SANCHAIE/rover-90-workshop/handouts/ใบตรวจสาย.docx

ใบตรวจสาย ROVER 90

ทีมที่ / ชื่อทีม | สมาชิก | เวลาที่เริ่ม

ต่อให้ครบทุกเส้น ทำเครื่องหมายในช่องขวาสุด แล้วยกมือเรียกครูตรวจ ห้ามเปิดสวิตช์ถ่านก่อนครูเซ็นชื่อ

กลุ่มที่ 1 ไฟเลี้ยง — ต่อกลุ่มนี้ให้เสร็จและถูกก่อนเสมอ

จาก | ไปที่ | เส้น | ตรวจแล้ว
กล่องถ่าน 18650 (สายแดง) | L298N ขั้ว 12V | 1
กล่องถ่าน 18650 (สายดำ) | L298N ขั้ว GND | 1
L298N ขา 5V | ESP32 ขา VIN | 1
L298N ขา GND | ESP32 ขา GND | 1

เช็ก jumper 5V-EN บน L298N ต้องคาไว้ ไม่งั้นจะไม่มีไฟ 5V ออกมาเลี้ยง ESP32

กลุ่มที่ 2 มอเตอร์และสายควบคุม

จาก | ไปที่ | เส้น | ตรวจแล้ว
มอเตอร์ซ้าย 2 เส้น | L298N OUT1 และ OUT2 | 2
มอเตอร์ขวา 2 เส้น | L298N OUT3 และ OUT4 | 2
L298N ENA | ESP32 ขา 14 | 1
L298N IN1 | ESP32 ขา 27 | 1
L298N IN2 | ESP32 ขา 26 | 1
L298N IN3 | ESP32 ขา 25 | 1
L298N IN4 | ESP32 ขา 33 | 1
L298N ENB | ESP32 ขา 32 | 1

ถอด jumper ครอบ ENA และ ENB ออกก่อน ไม่งั้นปรับความเร็วไม่ได้

กลุ่มที่ 3 เซนเซอร์ จอ และเสียง

จาก | ไปที่ | เส้น | ตรวจแล้ว
HC-SR04 VCC | ESP32 ขา 5V | 1
HC-SR04 TRIG | ESP32 ขา 5 | 1
HC-SR04 ECHO | ESP32 ขา 18 ผ่านตัวแบ่งแรงดัน | 1
OLED VCC | ESP32 ขา 3V3 (ห้ามใช้ 5V) | 1
OLED SDA | ESP32 ขา 21 | 1
OLED SCL | ESP32 ขา 22 | 1
Buzzer ขั้วบวก | ESP32 ขา 4 | 1
GND ของ HC-SR04 + OLED + Buzzer | ESP32 ขา GND (รวมกันได้) | 3

ตรวจซ้ำ 4 ข้อนี้ก่อนเรียกครู

1. ขั้วถ่านเข้า L298N ถูกด้าน ผิด = โมดูลพังทันที ควันขึ้น

2. สาย GND ระหว่าง L298N กับ ESP32 ต่ออยู่ ขาด = มอเตอร์ทำงานมั่ว หาสาเหตุยากที่สุด

3. ขา ECHO ผ่านตัวแบ่งแรงดันแล้ว ข้าม = ขา ESP32 เสื่อมแบบค่อยเป็นค่อยไป

4. OLED ใช้ไฟ 3V3 ไม่ใช่ 5V ผิด = จอไหม้

ผลการตรวจ | ลงชื่อครูผู้ตรวจ | เวลา
ผ่าน / ให้แก้ไขแล้วตรวจใหม่

เมื่อมีลายเซ็นในช่องนี้แล้วเท่านั้น จึงเปิดสวิตช์ถ่านได้
