SANCHAIE/rover-90-workshop/optional/google-sheet-iot/README.md

# ทางเลือก · ส่งข้อมูลขึ้นกราฟ Google Sheet

> **ไม่ได้ใช้ในแผนกิจกรรมปัจจุบัน** ถ้ากำลังเตรียมสอนตามแผนใน `docs/index.html`
> ให้ข้ามโฟลเดอร์นี้ไปทั้งหมด ส่วน IoT ใช้ `firmware/05_WebServer` แทน

---

## ทำไมถึงไม่ได้ใช้

แผนแรกออกแบบให้รถทุกคันยิงผลการจูนขึ้น Google Sheet ผ่านฮอตสปอตมือถือครู แล้วฉายกราฟรวมของทั้ง 15 ทีมขึ้นจอพร้อมกัน

สุดท้ายเปลี่ยนไปใช้ SoftAP บนตัวรถแทน ด้วยสามเหตุผล

- ฮอตสปอตมือถือรับได้แค่ 5 เครื่อง (iPhone) ถึง 10 เครื่อง (Android) ไม่พอสำหรับ 15 ทีม ต้องหมุนเวียนเข้าคิว
- ต้องเตรียม Apps Script และ Deploy ล่วงหน้า ถ้าตั้งค่าพลาดจุดเดียวคือใช้ไม่ได้ทั้งห้อง
- ถ้าเน็ตล่มกลางคาบ ส่วน IoT หายไปทั้งช่วง ไม่มีทางถอย

`05_WebServer` ไม่ต้องมีเราเตอร์ ไม่ต้องมีเน็ต ไม่ต้องตั้งค่าอะไรล่วงหน้าเลย

## เมื่อไรถึงควรกลับมาใช้

โค้ดในโฟลเดอร์นี้ทดสอบแล้วและใช้ได้จริง เก็บไว้เผื่อกรณี

- ห้องมี WiFi ที่ควบคุมได้เอง และอยากได้กราฟเปรียบเทียบทั้งห้องฉายขึ้นจอ
- จำนวนทีมน้อยกว่า 8 ทีม ฮอตสปอตมือถือรับไหว
- อยากสอนเรื่องการส่งข้อมูลขึ้นคลาวด์จริง ๆ ไม่ใช่แค่เว็บเซิร์ฟเวอร์ในเครื่อง

## ไฟล์ในโฟลเดอร์นี้

| ไฟล์ | คืออะไร |
|---|---|
| `setup.md` | คู่มือติดตั้ง Google Sheet และ Apps Script 7 ขั้น |
| `Code.gs` | สคริปต์ฝั่ง Google Sheet รับข้อมูลแล้วเขียนลงแท็บ `data` |
| `05_SendToSheet/` | สเก็ตช์ ESP32 เชื่อม WiFi ยิงข้อมูล แล้วตัดการเชื่อมต่อใน 5 วินาที |
