SANCHAIE/rover-90-workshop/handouts/ใบงานนักเรียน.docx

ใบงาน ROVER 90

ต่อวงจรเอง เขียนโค้ดเอง ปรับจูนจนแม่น

ทีมที่ / ชื่อทีม | ชื่อรถ | วันที่

สมาชิกในทีม

1. ______________________ 2. ______________________ 3. ______________________

ส่วนที่ 1 · เดินสาย

ทำใบตรวจสายให้ครบก่อน แล้วให้ครูเซ็น จึงเปิดสวิตช์ได้

1.1 ทดสอบด้วยโค้ด 01 Hello Rover ทำเครื่องหมายสิ่งที่เกิดขึ้นจริง

สิ่งที่ควรเกิด | เกิดขึ้นจริงไหม | ถ้าไม่ ทำอะไรเพื่อแก้
จอ OLED ขึ้นชื่อทีม
ล้อซ้ายหมุนก่อน
ล้อขวาหมุนตามมา
buzzer ร้อง 2 ครั้ง

1.2 ทีมเราต่อสายผิดกี่เส้น และผิดตรงไหน

ส่วนที่ 2 · เขียนโค้ดให้รถวิ่ง

2.1 เติมฟังก์ชันทั้ง 5 ตัว เขียนคำตอบลงในช่องก่อนพิมพ์ลงคอม

เครื่องมือที่มีให้ใช้คือ leftMotor(ทิศทาง, ความเร็ว) และ rightMotor(ทิศทาง, ความเร็ว)

ทิศทาง : 1 = เดินหน้า -1 = ถอยหลัง 0 = หยุด

ฟังก์ชัน | ล้อซ้ายใส่ทิศทางเท่าไร | ล้อขวาใส่ทิศทางเท่าไร
forward()
backward()
turnLeft()
turnRight()
stopAll()

2.2 ออกแบบภารกิจของทีมเราเอง เขียนลำดับคำสั่งให้รถไปแล้วกลับที่เดิม

ลำดับ | คำสั่ง | เวลา (ms) | รถจะทำอะไร
1 | forward(SPEED) | 2000 | เดินหน้าประมาณ 1 ช่วงแขน
2
3
4
5

แถวแรกเป็นตัวอย่างที่ให้ไว้แล้ว เขียนต่อเอง จะกี่แถวก็ได้

2.3 ลองเปลี่ยนค่าความเร็วแล้วสังเกต

ค่า SPEED | ล้อหมุนไหม | เร็ว / ช้า | เสียงมอเตอร์
80
120
180
255

ค่าต่ำสุดที่ล้อยังหมุนไหว = ________________

ส่วนที่ 3 · ปรับจูนจนแม่น

ใช้ SPEED ค่าเดียวตลอดส่วนนี้ ห้ามเปลี่ยนกลางคัน SPEED ที่เลือก = __________

3.1 หาว่า 1 เซนติเมตรใช้เวลากี่มิลลิวินาที (โหมด TEST 2s)

ครั้งที่ | เวลาที่สั่ง (ms) | ระยะที่วัดได้ (ซม.) | เวลา ÷ ระยะ
1 | 2000
2 | 2000
3 | 2000

ค่าเฉลี่ย MS_PER_CM = ________________ แล้วใส่ค่านี้ลงในโค้ด

3.2 รถวิ่งตรงหรือเบี้ยว

เมื่อสั่งวิ่งตรง รถเบนไปทางใด ☐ ตรงดี ☐ เบนซ้าย ☐ เบนขวา

ครั้งที่ | TRIM_L ที่ลอง | TRIM_R ที่ลอง | ผลที่ได้
1 | 1.00 | 1.00
2
3

3.3 ภารกิจวัดผล สั่งให้หยุดที่เส้น 100 ซม.

รอบที่ | ระยะที่หยุดจริง (ซม.) | คลาดเคลื่อน (ซม.) | เกินเป้า / ไม่ถึงเป้า
1
2

คลาดเคลื่อนเฉลี่ย = ________________ ซม. ตัวเลขนี้จะได้ใช้ในส่วนที่ 5

3.4 ถ้าเปลี่ยนถ่านเป็นก้อนที่ใช้มาแล้ว ค่าที่จูนไว้จะยังใช้ได้ไหม เพราะอะไร

ส่วนที่ 4 · เซนเซอร์

ระยะ (ซม.) = เวลา (ไมโครวินาที) × 0.0343 ÷ 2 เพราะเสียงเดินทาง 343 เมตรต่อวินาที และวัดได้เป็นระยะไป-กลับ

4.1 เทียบค่าที่อ่านได้กับไม้บรรทัด

ระยะจริง (ซม.) | ค่าที่จอแสดง | คลาดเคลื่อน (ซม.)
10
30

4.2 ภารกิจ ขับเข้าหากำแพงแล้วหยุดเอง

ค่า STOP_CM ที่ตั้ง | ระยะที่หยุดจริง (ซม.) | หยุดทันไหม
15

4.3 ถ้าลด STOP_CM ให้เหลือ 5 ซม. คิดว่ารถจะหยุดทันไหม เพราะอะไร

ส่วนที่ 5 · รถกลายเป็นเว็บเซิร์ฟเวอร์

5.1 บันทึกการเชื่อมต่อ

หัวข้อ | สิ่งที่บันทึกได้
ชื่อ WiFi ที่รถปล่อยออกมา
เลขที่พิมพ์ในเบราว์เซอร์
เดินห่างจากรถได้ไกลสุดกี่เมตรก่อนหลุด

5.2 ทุกทีมใช้เลข 192.168.4.1 เหมือนกันหมด ทำไมถึงไม่ชนกัน

5.3 รถไม่ได้ต่ออินเทอร์เน็ตเลย แบบนี้เรียกว่า IoT ได้หรือไม่ เพราะอะไร

สรุปท้ายกิจกรรม

ข้อ 1 รถทุกคันใช้ของชุดเดียวกันและโค้ดเดียวกัน ทำไมค่า MS_PER_CM ของแต่ละทีมไม่เท่ากัน

ข้อ 2 ต้องเพิ่มอุปกรณ์อะไรเข้าไป รถถึงจะไม่ต้องจูนใหม่ทุกครั้งที่เปลี่ยนถ่าน

ข้อ 3 สิ่งที่คิดว่าจะง่ายแต่กลับยาก คืออะไร

ตารางคะแนน (ครูกรอก)

รายการ | เกณฑ์ | เต็ม | ได้
เดินสายผ่านการตรวจ | ครูเซ็นชื่อในใบตรวจสาย | 20
เขียนฟังก์ชันครบ 5 ตัว | รถทำตามคำสั่งได้ถูกทิศ | 20
ออกแบบภารกิจเอง | รถกลับมาใกล้จุดเริ่มต้น | 15
ปรับจูนที่ระยะ 100 ซม. | คลาดเคลื่อนเฉลี่ยต่ำกว่า 5 ซม. | 20
เซนเซอร์หยุดก่อนชน | ไม่ชนกำแพงเลย | 10
ใบงานครบถ้วน | มีข้อมูลการทดลองจริง | 10
ทำงานเป็นทีม | ทุกคนได้จับสายและเขียนโค้ด | 5
รวม | | 100
