SANCHAIE/rover-90-workshop/docs/wiring.html

คู่มือช่วงเดินสาย · นาทีที่ 08–28

# ผังการต่อสาย Rover 90

ต่อทีละกลุ่มตามลำดับในหน้านี้ อย่าข้ามไปกลุ่มหลังก่อน เพราะกลุ่มแรกคือกลุ่มเดียวที่ต่อผิดแล้วของพัง

ไฟบวก

กราวด์ (GND)

ฝั่งล้อซ้าย

ฝั่งล้อขวา

อัลตราโซนิก

จอ OLED

buzzer

## กลุ่มที่ 1 · นาทีที่ 08–14

ไฟเลี้ยง

กลุ่มเดียวที่ต่อผิดแล้วโมดูลไหม้ ต่อให้เสร็จและถูกก่อนแตะกลุ่มอื่น สังเกตว่าไฟเดินทางเป็นทอด ๆ จากถ่านเข้า L298N แล้วค่อยแบ่งออกมาเลี้ยง ESP32 ไม่ได้ต่อถ่านเข้า ESP32 ตรง ๆ

4 เส้น · ถ่านเข้าขั้ว 12V และ GND ของ L298N จากนั้น L298N แบ่งไฟ 5 โวลต์ออกมาเลี้ยง ESP32 ผ่านขา VIN และต้องมีสาย GND เชื่อมสองบอร์ดถึงกันด้วยเสมอ

ผิดแล้วพังสลับขั้วถ่านเข้า L298N คือความผิดพลาดเดียวในคาบนี้ที่ทำให้ของไหม้ทันที ตรวจสีสายก่อนขันน็อตทุกครั้ง แดงเข้า 12V ดำเข้า GND

ต้องคาไว้jumper สีเหลือง 5V-EN บน L298N ถ้าถอดออก ขา 5V จะไม่มีไฟ และ ESP32 จะไม่ติดเลยทั้งที่ต่อครบทุกเส้น

## กลุ่มที่ 2 · นาทีที่ 14–20

มอเตอร์และสายควบคุม

กลุ่มนี้ต่อผิดไม่พัง แค่รถวิ่งกลับทาง แก้ทีหลังได้ ให้แยกสีจำเป็นฝั่ง ส้มคือฝั่งซ้ายทั้งชุด น้ำเงินคือฝั่งขวาทั้งชุด

10 เส้น · มอเตอร์ 4 เส้นเข้าขั้วสกรู และสายควบคุม 6 เส้นจาก L298N ไป ESP32 ต่อสายมอเตอร์กลับขั้วไม่พัง แค่ล้อหมุนกลับทาง

ถอดก่อนถอด jumper สีดำที่ครอบขา ENA และ ENB ออกก่อนเดินสาย ถ้าลืม จะเสียบสายไม่ได้และปรับความเร็วไม่ได้

ผิดได้ถ้าอัปโหลดโค้ด 01 แล้วล้อหมุนถอยหลัง ให้สลับสายมอเตอร์สองเส้นของข้างนั้น ถ้าล้อขวาหมุนก่อนล้อซ้าย แปลว่าสายควบคุมสลับฝั่ง

## กลุ่มที่ 3 · นาทีที่ 20–26

เซนเซอร์ จอ และเสียง

ทุกเส้นในกลุ่มนี้ต่อเข้า ESP32 โดยตรง ไม่ผ่าน L298N จุดที่ต้องระวังคือแรงดันไฟเลี้ยง อัลตราโซนิกใช้ 5 โวลต์ แต่จอใช้ 3.3 โวลต์ ห้ามสลับกัน

10 เส้น · อัลตราโซนิกกินไฟ 5 โวลต์ จอ OLED กินไฟ 3.3 โวลต์ ส่วน GND ใช้เส้นเดียวแล้วแยกไปสามจุดได้ ผ่าน breadboard

ผิดแล้วพังต่อไฟ 5 โวลต์เข้าจอ OLED จะทำให้จอไหม้ จอต้องรับจากขา 3V3 เท่านั้น ตรวจซ้ำก่อนเปิดสวิตช์

## รายละเอียดที่ห้ามข้าม

ตัวแบ่งแรงดันบนขา ECHO

HC-SR04 ส่งสัญญาณกลับมาที่ 5 โวลต์ แต่ขา ESP32 รับได้แค่ 3.3 โวลต์ ต่อตรงแล้วทำงานได้ในวันแรก แต่ขาจะเสื่อมไปเรื่อย ๆ จนพังในอีกไม่กี่สัปดาห์ ครูควรบัดกรีส่วนนี้ติดสายไว้ล่วงหน้าทั้ง 15 ชุด

สูตร · แรงดันที่ออกมา = 5 × 2 ÷ (1 + 2) = 3.3 โวลต์พอดี ถ้าไม่มีตัวต้านทาน 2 kΩ ให้ใช้ 1 kΩ ต่ออนุกรมสองตัวแทนได้

## สรุปเป็นตัวอักษร

ตารางเทียบขา

รูปข้างบนไม่ได้วาดตำแหน่งขาให้ตรงกับบอร์ดจริงเป๊ะ เพราะ ESP32 แต่ละรุ่นเรียงขาไม่เหมือนกัน ให้ยึด ตัวอักษรที่พิมพ์อยู่บนบอร์ด เป็นหลักเสมอ

กลุ่ม | จาก | ไปที่ | สีสายที่แนะนำ
1 | ถ่าน + | L298N 12V | แดง
1 | ถ่าน − | L298N GND | ดำ
1 | L298N 5V | ESP32 VIN | แดง
1 | L298N GND | ESP32 GND | ดำ
2 | มอเตอร์ซ้าย | OUT1 OUT2 | ส้ม
2 | มอเตอร์ขวา | OUT3 OUT4 | น้ำเงิน
2 | ENA IN1 IN2 | 14 · 27 · 26 | ส้ม
2 | IN3 IN4 ENB | 25 · 33 · 32 | น้ำเงิน
3 | HC-SR04 VCC | ESP32 5V | แดง
3 | HC-SR04 TRIG | ESP32 5 | ฟ้า
3 | HC-SR04 ECHO | ESP32 18 ผ่านตัวแบ่งแรงดัน | ฟ้า
3 | OLED VCC | ESP32 3V3 | แดง
3 | OLED SDA SCL | ESP32 21 · 22 | เขียว
3 | Buzzer + | ESP32 4 | ม่วง
3 | GND ของทั้งสามตัว | ESP32 GND | ดำ

## ทำต่อได้อีก

ถ่ายรูปรถต้นแบบไว้ใช้แทนรูปวาด

เมื่อประกอบรถต้นแบบคันแรกเสร็จ ถ่ายรูป 6 รูปนี้ไว้ รูปถ่ายของจริงจะช่วยเด็กได้มากกว่ารูปวาด เพราะเห็นว่าสายจริงพันกันแบบไหนและหัวเสียบหน้าตาอย่างไร

#### รูป 1 ทั้งคันจากด้านบน

ถ่ายตรง ๆ จากข้างบน เห็นทุกโมดูลพร้อมกัน ใช้เป็นภาพเปิดตอนอธิบายว่ามีอะไรบ้าง

#### รูป 2 ขั้วสกรูของ L298N ระยะใกล้

ให้เห็นชัดว่าสายแดงอยู่ช่องไหน สายดำอยู่ช่องไหน และเห็น jumper 5V-EN ที่คาอยู่ นี่คือรูปที่สำคัญที่สุดในหกรูป

#### รูป 3 แถวขาของ ESP32 ระยะใกล้

ถ่ายให้อ่านตัวอักษรบนบอร์ดออก เด็กจะได้เทียบกับของตัวเองว่าขา 14 อยู่ตรงไหน

#### รูป 4 ตัวแบ่งแรงดันที่บัดกรีแล้ว

ให้เห็นว่าตัวต้านทานสองตัวอยู่ตรงไหนของสาย ECHO และหุ้มด้วยอะไร

#### รูป 5 จอ OLED และ buzzer ที่ติดตั้งแล้ว

เห็นว่าติดจอไว้ตรงไหนของรถ และหันหน้าไปทางไหนถึงจะอ่านได้ตอนรถวิ่ง

#### รูป 6 รถที่เปิดสวิตช์แล้วจอติด

ภาพเป้าหมาย ใช้บอกเด็กว่า “ต่อเสร็จแล้วต้องหน้าตาแบบนี้” ก่อนเริ่มลงมือ

ส่งมาได้ถ่ายเสร็จแล้วส่งรูปมา จะทำเป็นภาพพร้อมลูกศรและป้ายกำกับภาษาไทยชี้ทีละจุด แล้วรวมเข้ากับหน้านี้ให้

ใช้คู่กับใบตรวจสายที่แจกทีมละแผ่น · แนะนำให้ฉายหน้านี้ขึ้นจอตลอดช่วงนาทีที่ 08–28 และปริ๊นต์แปะไว้หน้าห้องอีกชุด
