SANCHAIE/rover-90-workshop/(commit log)

2026-08-29 Rover 90: ชุดเวิร์กช็อปหุ่นยนต์ ESP32 สำหรับ ม.ปลาย 90 นาที
    - firmware 7 สเก็ตช์ ตั้งแต่ทดสอบการต่อสาย เขียนโค้ดให้รถวิ่ง ปรับจูน
    อ่านเซนเซอร์ จนถึงเว็บเซิร์ฟเวอร์บนตัวรถ คอมไพล์ผ่าน ESP32 core 3.0.7
    - ส่วน IoT ใช้ SoftAP บนตัวรถ ไม่ต้องมีเราเตอร์หรืออินเทอร์เน็ต
    มีมาตรการกันคลื่นชน 3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
    [BOM.xlsx]
2026-08-29 เพิ่มเอกสารสำหรับปริ๊นต์แจกในคาบ
    - handouts/ใบตรวจสาย.docx 1 หน้า A4 แยกเป็น 3 กลุ่มตามลำดับการต่อ
    ไฟเลี้ยง มอเตอร์ เซนเซอร์ มีช่องติ๊กและช่องเซ็นชื่อครูก่อนอนุญาตให้จ่ายไฟ
    - handouts/ใบงานนักเรียน.docx 6 หน้า ตรงกับแผน 5 ส่วน
    เดินสาย เขียนโค้ด ปรับจูน เซนเซอร์ และเว็บเซ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
2026-08-29 bom: replace price list with equipment checklist
    [BOM.xlsx]
2026-08-29 docs: add visual wiring diagrams
2026-08-29 docs: new visual build-guide landing page, teacher plan moved to teacher.html
2026-08-29 docs: redraw system diagram with realistic board artwork
